zeugri/G2-frozen-frame/README.md

# G2 Frozen FPV racer frame

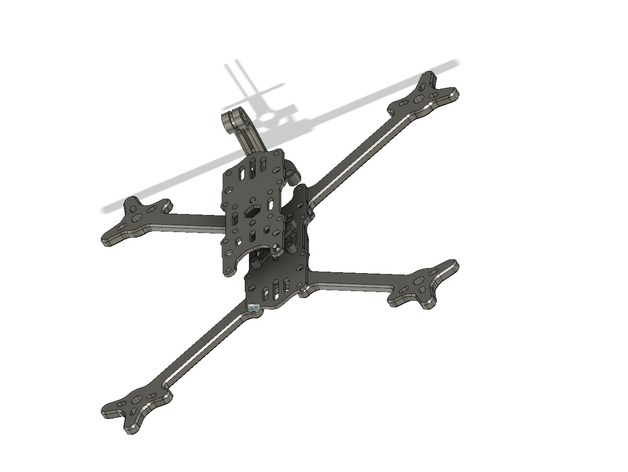
[picture p1: gfx/G2_render.jpg]
G2 render


G2 "frozen" is an open source FPV racer 5 inch frame.

The design is simple yet intended to be light & robust. My current setup weights 460 grams AUW. Not that bad.

## The full specs

 * simple & strong (5mm arms, 2 mm plates, same arms & plates)
 * stretch X 5 inch frame
 * micro cam, racewire, @tinysleds compliant
 * 20x20 and 30,5x30,5 hole patterns
 * 3 different mounting possibilities
 * 60-70 grams (depending of how you mount it).

## DXF Files for the frame

There are 3 files containing the different parts (arm, main plate, bottom plate)

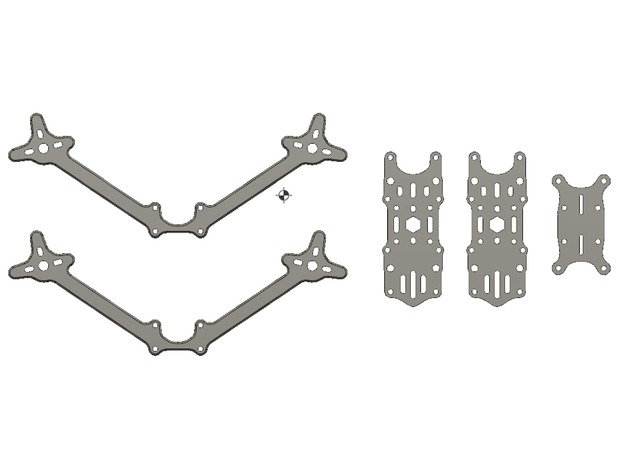
[picture p2: gfx/G2_components.jpg]
G2 components


You need to cut those in carbon fibre. You'll need :

2 x Arms in 5mm CF
2 x Plates in 2mm CF
1 x bottom plate in 2mm CF

Use your favorite CNC CF cutting service (Armattan productions, CNCDrone, etc. )

## The frame 3D printed accessories

Get those on the Thingiverse project : https://www.thingiverse.com/thing:3175254

Print the accessories you need using TPU filament :

 * 2 x Camera support
 * 1x 20 mm FC Support
 * simple crossfire immortal_t antenna supports that slides on the standoffs
 * simple VTX antenna support
 
## Other frame hardware you'll need (not provided here) :

 * M3 self locking nuts : https://www.banggood.com/Suleve-M3AN1-10Pcs-M3-Self-locking-Nylon-Nut-Aluminum-Alloy-Multi-color-p-1168920.html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
 * M3 x 20mm (5mm diam) standoffs : https://www.banggood.com/M3AR7-10Pcs-M3-20mm-Knurled-Standoff-Aluminum-Alloy-Anodized-Spacer-p-1118406.html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
 * M3 Screws (various lengths, from 6mm to 12mm) : https://www.banggood.com/Suleve-M3SH2-M3-Stainless-Steel-Hex-Socket-Button-Head-Screws-Allen-Bolt-Nut-Assortment-240pcs-p-1192716.html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
 * M3 pressnuts (I took M3/1.4mm slab) : https://www.aliexpress.com/item/Axk-50pcs-M2-M2-5-M3-M4-M5-M6-M8-Slab-Thickness-1-4mm-1-0mm/32839998522.html

## List of electronic components i use on my setup :

 * Motors : 4 x Brotherhobby 2207.5 2700 Kv : https://www.banggood.com/BrotherHobby-Speed-Shield-2207_5-1750KV-2400KV-2700KV-4-6S-Brushless-Motor-for-FPV-Racing-RC-Drone-p-1342190.html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
 * FC+ESC Combo : HGLRC F440 : https://www.banggood.com/HGLRC-XJB-F440-Omnibus-F4-Flight-Controller-OSD-BEC-40A-Blheli_32-3-5S-ESC-DSHOT1200-for-RC-Drone-p-1242939.html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
 * FPV Camera : Runcam Micro Sparrow 2 : https://www.banggood.com/Runcam-Micro-Sparrow-2-Super-WDR-OSD-700TVL-CMOS-FOV-150-Degree-2_1mm-43-FPV-Mini-Camera-NTSC-PAL-p-1271733.html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
 * AKK FX3 VTX : https://www.akktek.com/products/vtx/akk-fx3.html
 * FPV Antenna : Foxeer Lollipop SMA : https://www.banggood.com/Foxeer-Lollipop-2-RHCP-SMARP-SMA-5_8G-2_5dBi-Super-Mini-Antenna-For-FPV-Racing-Drone-p-1337714.html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
 * Remote RX : TBS Crossfire Nano RX + Immortal T antenna : https://www.team-blacksheep.com/products/prod:crossfire_nano_se

Do not hesitate to contact me if you need more infos.
