zeugri/G2-frozen-frame/DXF/G2_plate_2mm.dxf

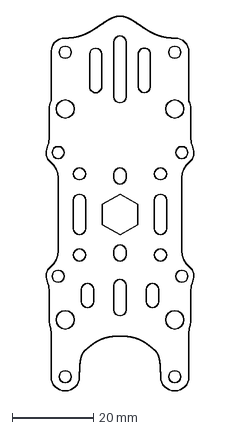
[picture p3: CAD file, 2018-11-05]
DXF/G2_plate_2mm.dxf
37.1 x 92.4 mm
