zeugri/G2-frozen-frame/DXF/G2_arm_5mm.dxf

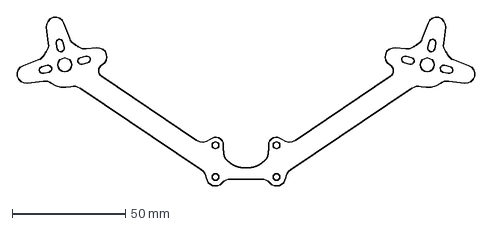
[picture p4: CAD file, 2018-11-02]
DXF/G2_arm_5mm.dxf
202.8 x 75.2 mm
