zeugri/G2-frozen-frame/DXF/G2_under_plate_2mm.dxf

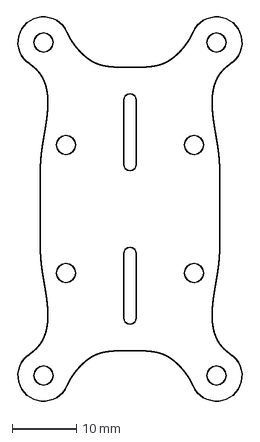
[picture p5: CAD file, 2018-11-02]
DXF/G2_under_plate_2mm.dxf
35.6 x 60.3 mm
