zeugri/G2-frozen-frame/(commit log)

2018-11-02 initial commit : added dxf frame files
    [G2_arm_5mm.dxf, G2_plate_2mm.dxf, G2_under_plate_2mm.dxf]
2018-11-05 updated plate with wider pressnuts holes (4.2 mm -> 4.5 mm)
    [G2_plate_2mm.dxf]
